chandimab/usb-to-serial/documentation/sticker.docx

2019 | Ver1.0

USB to Serial

GROUP 14

Serial Interface

TXn

S0

GND

RXn

S7
