chandimab/usb-to-serial/arduino/controller-algo-flow-diagram.png

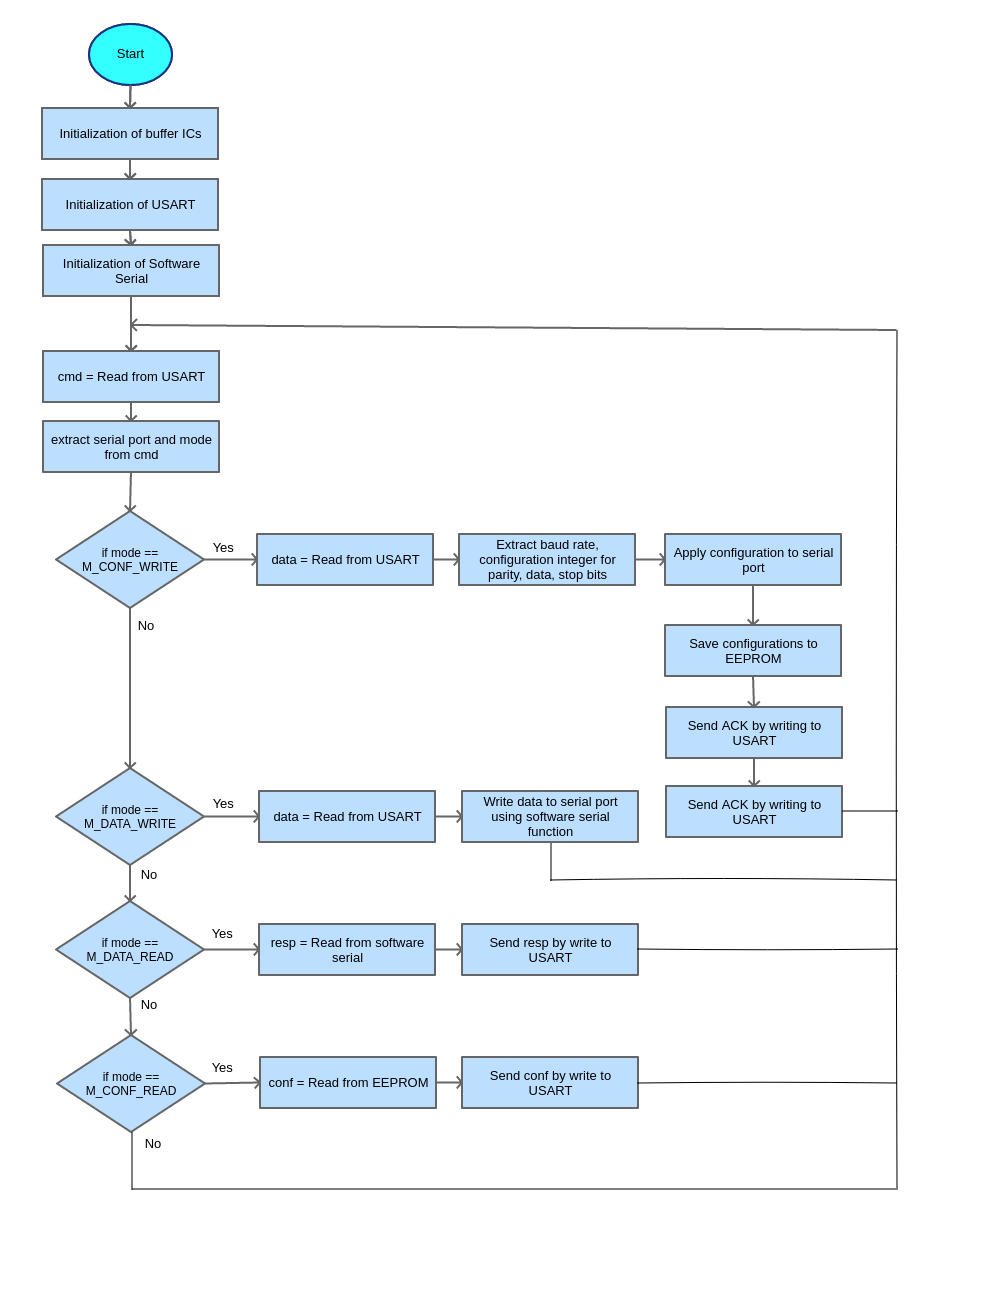
arduino/controller-algo-flow-diagram.png
