chandimab/usb-to-serial/circuit/circuit.png

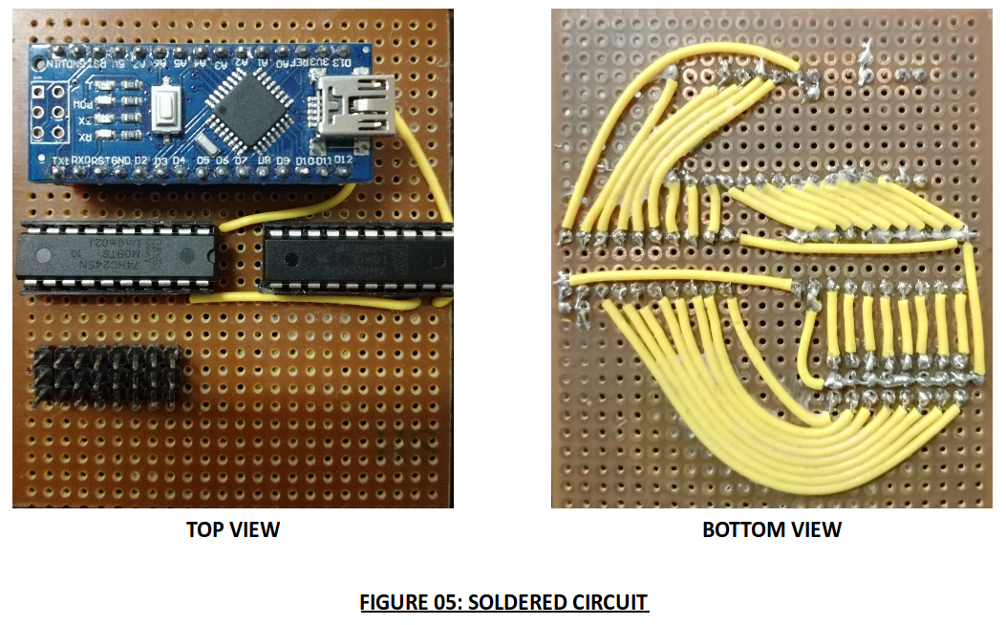
circuit/circuit.png
