chandimab/usb-to-serial/samples/sample software.png

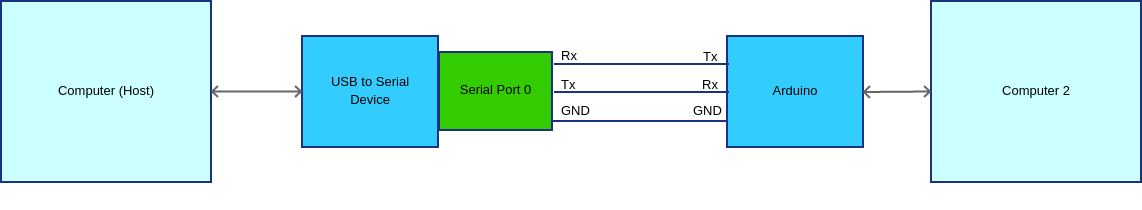
samples/sample software.png
