chandimab/usb-to-serial/(commit log)

2019-02-19 arduino sketch and gui files were added.
    [co326_serial_3_2.brd, co326_serial_3_2.sch]
2019-02-19 arduino software completed.
2019-02-20 GUI main functionality and the arduino sketch was developed completly and tested successfully
2019-02-20 library added. initial test successfull. Not tested with proper sample.
